craftvia/craftvia-core-s-RP235xA/docs/images/2D_PCB1_back_2026-11-04.png

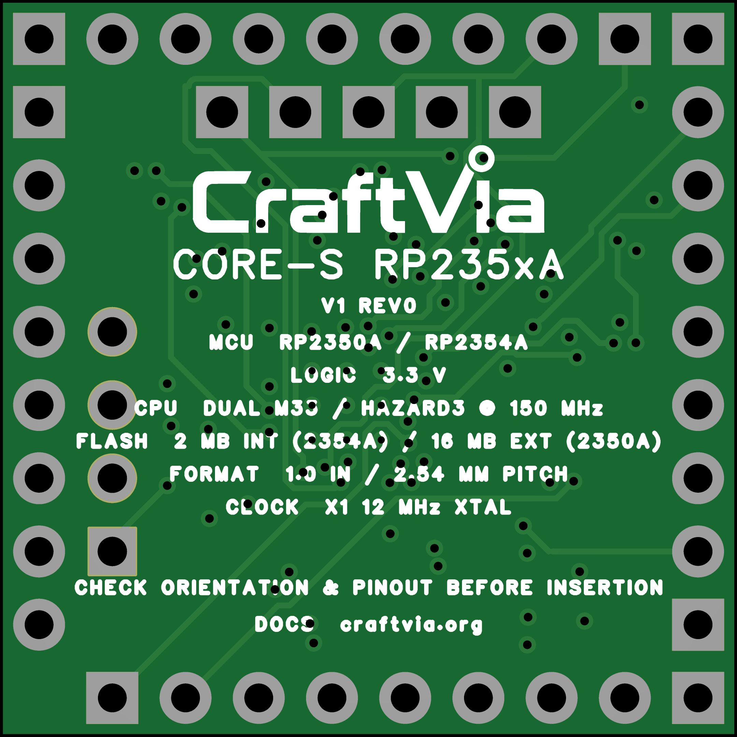
docs/images/2D_PCB1_back_2026-11-04.png
