craftvia/craftvia-core-s-RP235xA/assembly/BOM_Board1_PCB1_2026-11-04.csv

No. | Quantity | Comment | Designator | Footprint | Value | Manufacturer Part | Manufacturer | Supplier Part | Supplier | LCSC Part Name | Description | Mounting Type | DNP
1 | 10 | 100n | C1,C2,C3,C4,C5,C6,C7,C8,C9,C10 | C0402 | 100n | GRM155R71E104KE14D | muRata(村田) | C77014 | LCSC | 100nF ±10% 25V | Capacitance:100nF Tolerance:±10% Tolerance:±10% Voltage Rating:25V Temperature Coefficient:X7R
2 | 3 | 4.7u | C11,C12,C13 | C0402 | 4.7u | GRM155R60J475ME47D | muRata(村田) | C82453 | LCSC | 4.7uF ±20% 6.3V | Capacitance:4.7uF Tolerance:±20% Tolerance:±20% Voltage Rating:6.3V Temperature Coefficient:X5R
3 | 1 | 10u | C14 | C0805 | 10u | GRM21BR61C106KE15L | muRata(村田) | C77075 | LCSC | 10uF ±10% 16V | Capacitance: Tolerance:±10% Tolerance:±10% Voltage Rated: Temperature Coefficient:
4 | 2 | 15p | C15,C16 | C0402 | 15p | GRM1555C1H150JA01D | muRata(村田) | C76950 | LCSC | 15pF ±5% 50V | Capacitance:15pF Tolerance:±5% Tolerance:±5% Voltage Rating:50V Temperature Coefficient:C0G
5 | 1 | 100n (RP2350A ONLY / DNP RP2354A) | C17 | C0402 | 100nF | GRM155R71E104KE14D | muRata(村田) | C77014 | LCSC | 100nF ±10% 25V | Capacitance:100nF Tolerance:±10% Tolerance:±10% Voltage Rating:25V Temperature Coefficient:X7R |  | RP2354A
6 | 1 | N 1-8 | J1 | HDR-TH_8P-P2.54-V-M |  | 直排针2.54mm 1*8P |  | Header2.54mm 1*8P.1 | LCSC
7 | 1 | E 1-8 | J2 | HDR-TH_8P-P2.54-V-M |  | 直排针2.54mm 1*8P |  | Header2.54mm 1*8P.1 | LCSC
8 | 1 | S 1-8 | J3 | HDR-TH_8P-P2.54-V-M |  | 直排针2.54mm 1*8P |  | Header2.54mm 1*8P.1 | LCSC
9 | 1 | W 1-8 | J4 | HDR-TH_8P-P2.54-V-M |  | 直排针2.54mm 1*8P |  | Header2.54mm 1*8P.1 | LCSC
10 | 1 | K-NW | J5 | CraftVia-Core-S-KEY-TH_1P-P2.54-D1.00-P1.80 |  | 2.54-1*1P针 | BOOMELE(博穆精密) | Header-Male-2.54_1x1.1 | LCSC
11 | 1 | K-NE | J6 | CraftVia-Core-S-KEY-TH_1P-P2.54-D1.00-P1.80 |  | 2.54-1*1P针 | BOOMELE(博穆精密) | Header-Male-2.54_1x1.1 | LCSC
12 | 1 | K-SW | J7 | CraftVia-Core-S-KEY-TH_1P-P2.54-D1.00-P1.80 |  | 2.54-1*1P针 | BOOMELE(博穆精密) | Header-Male-2.54_1x1.1 | LCSC
13 | 1 | AUX GPIO20-23 / 2.54mm PTH | J8 | HDR-TH_HDR-M_2.54_1X4P |  | HDR-M_2.54_1x4P |  | C9900236824 | LCSC | HDR-M_2.54_1x4P
14 | 1 | AOTA-B201610S3R3-101-T | L1 | IND-SMD_L2.0-W1.6_AOTA-B201610S3R3-101-T | 3.3uH | AOTA-B201610S3R3-101-T | ABRACON | C42411119 | LCSC | 3.3uH 2.4A
15 | 1 | 0R / FB INPUT FILTER | R1 | R0603 | 0R | 0603WAF0000T5E | UNI-ROYAL(厚声) | 0603WAF0000T5E.1 | LCSC |  | Default 0 ohm. Replace with same-footprint ferrite bead only after noise/ADC/EMI evaluation. |  | No
16 | 1 | 33 | R2 | R0402 | 33 | RC0402FR-0733RL | YAGEO(国巨) | C138002 | LCSC | 厚膜电阻 33Ω ±1% 62.5mW | Type:Thick Film Resistor Resistance:33Ω Tolerance:±1% Tolerance:±1% Power(Watts):62.5mW Voltage-Supply(Max):50V Temperature Coefficient:±100ppm/℃ Temperature Coefficient:±100ppm/℃ Operating Temperature:-55℃~+155℃ Operating Temperature:-55℃~+155℃
17 | 2 | 1k | R3,R4 | R0402 | 1k | RC0402FR-071KL | YAGEO(国巨) | C106235 | LCSC | 厚膜电阻 1kΩ ±1% 62.5mW | Type:Thick Film Resistor Resistance:1kΩ Tolerance:±1% Tolerance:±1% Power(Watts):62.5mW Voltage-Supply(Max):50V Temperature Coefficient:±100ppm/℃ Temperature Coefficient:±100ppm/℃ Operating Temperature:-55℃~+155℃ Operating Temperature:-55℃~+155℃
18 | 2 | 27 | R5,R6 | R0402 | 27 | RC0402FR-0727RL | YAGEO(国巨) | C138021 | LCSC | 厚膜电阻 27Ω ±1% 62.5mW | Type:Thick Film Resistor Resistance:27Ω Tolerance:±1% Tolerance:±1% Power(Watts):62.5mW Voltage-Supply(Max):50V Temperature Coefficient:±100ppm/℃ Temperature Coefficient:±100ppm/℃ Operating Temperature:-55℃~+155℃ Operating Temperature:-55℃~+155℃
19 | 1 | 0R (RP2350A ONLY / DNP RP2354A) | R7 | R0402 | 0Ω | RC0402JR-070RL | YAGEO(国巨) | C60485 | LCSC | 厚膜电阻 0Ω ±5% 62.5mW | Type:Thick Film Resistor Resistance:0Ω Tolerance:±5% Tolerance:±5% Power(Watts):62.5mW Voltage-Supply(Max):50V Temperature Coefficient:- Temperature Coefficient:- Operating Temperature:-55℃~+155℃ Operating Temperature:-55℃~+155℃ |  | RP2354A
20 | 1 | 10k (RP2350A ONLY / DNP RP2354A) | R8 | R0402 | 10kΩ | RC0402FR-0710KL | YAGEO(国巨) | C60490 | LCSC | 厚膜电阻 10kΩ ±1% 62.5mW | Type:Thick Film Resistor Resistance:10kΩ Tolerance:±1% Tolerance:±1% Power(Watts):62.5mW Voltage-Supply(Max):50V Temperature Coefficient:±100ppm/℃ Temperature Coefficient:±100ppm/℃ Operating Temperature:-55℃~+155℃ Operating Temperature:-55℃~+155℃ |  | RP2354A
21 | 1 | RP2354A | U1 | QFN-60_L7.0-W7.0-P0.40-TL-EP3.4 | RP2354A | RP2354A | Raspberry Pi(树莓派) | C41378174 | LCSC | SC1511(13)-A4 | CPU Core:ARM Cortex-M33 CPU Maximum Speed:150MHz Core Size:32 Bit Oscillator Type:Built-in+External Features:Independent watchdog (IWDG)；Undervoltage detection (BOR/LVD/LVR/LVI)；Calendar function；Power-on reset (POR)；True random number generator (TRNG)；Wa
22 | 1 | W25Q128JVSIQ (RP2350A ONLY / DNP FOR RP2354A) | U2 | SOIC-8_L5.3-W5.3-P1.27-LS8.0-BL |  | W25Q128JVSIQ | Winbond(华邦) | C97521 | LCSC | 编带 支持双路/四路SPI接口的3V、128Mbit 串行闪存 | Interface:SPI Memory Size:128Mbit Clock Frequency:133MHz Voltage - Supply:2.7V~3.6V Voltage - Supply:2.7V~3.6V Standby Supply Current:1uA Program / Erase Cycles:100,000 cycles Write Cycle Time (tWC):- Page Programming Time (Tpp):3ms Block Erase Time(tBE): |  | RP2354A
23 | 1 | 12MHz | X1 | CRYSTAL-SMD_4P-L3.2-W2.5-BL | 12MHz | ABM8-272-T3 | ABRACON | C20625731 | LCSC | 12MHz ±30ppm 10pF | Type:SMD crystal oscillator Frequency:12MHz Normal temperature Frequency Tolerance:±30ppm Normal temperature Frequency Tolerance:±30ppm Load Capacitance:10pF Frequency Stability:±30ppm Frequency Stability:±30ppm Equivalent Series Resistance(ESR):50Ω Opera
