craftvia/craftvia-core-s-RP235xA/docs/SCH_Schematic1_2026-11-04.pdf

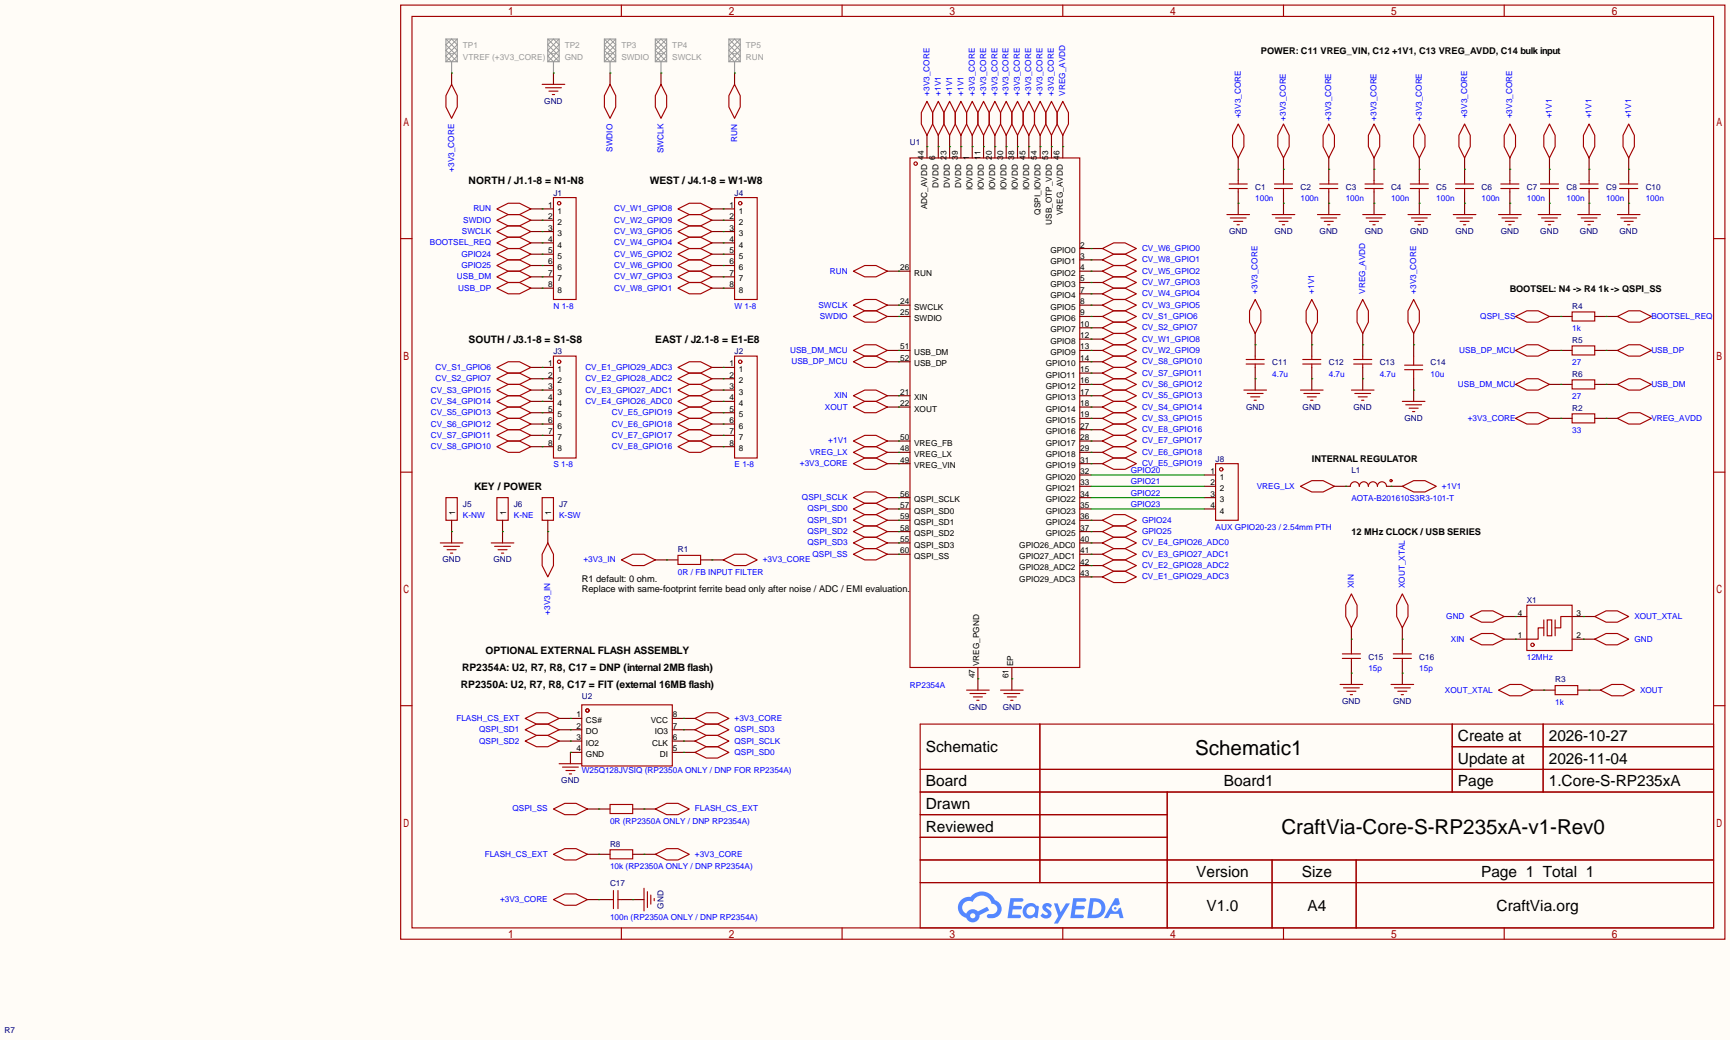
[picture p4: page 1]

12 MHz CLOCK / USB SERIES

R1 default: 0 ohm.
Replace with same-footprint ferrite bead only after noise / ADC / EMI evaluation.

OPTIONAL EXTERNAL FLASH ASSEMBLY
RP2354A: U2, R7, R8, C17 = DNP (internal 2MB flash)
RP2350A: U2, R7, R8, C17 = FIT (external 16MB flash)

Schematic | Schematic1 | Create at | 2026-10-27

Update at | 2026-11-04

Board | Board1 | Page | 1.Core-S-RP235xA
Drawn | | CraftVia-Core-S-RP235xA-v1-Rev0
Reviewed

Version | Size | Page 1 Total 1
V1.0 | A4 | CraftVia.org
