craftvia/craftvia-core-s-RP235xA/(list of files, drawings)

Other design files:
source/ProPrj_CraftVia-Core-S-RP235xA-v1-Rev0_2026-11-04.epro
