craftvia/craftvia-core-s-RP235xA/RELEASE_NOTES.md

# CraftVia Core-S RP235xA v1 Rev0 Hardware Release

## Release status

- Revision: Rev0
- Freeze date: 2026-11-04 00:03 JST
- Status: FROZEN for initial prototype PCB fabrication
- Hardware status: PCB ordered; awaiting delivery, unassembled and unverified
- Intended use: Rev0 engineering prototype; not a general-production release
- Default assembly variant: `RP2354A + internal 2 MB Flash`
- Alternate assembly variant: `RP2350A + external W25Q128JVSIQ 16 MB Flash`
- Assembly plan: bare-PCB fabrication followed by manual/hot-plate assembly; no turnkey PCBA is planned for the first article
- CAD: EasyEDA Pro `v3.2.209`; frozen project database schema `25.10.31.1`
- Checked by: Kohei (design owner) and Codex (release-file consistency review)
- Authoritative editable source: `source/CraftVia-Core-S-RP235xA-v1-Rev0.eprj2`
- Authoritative source SHA-256: `5936228bfc046cde501f23ae7750e1628e2d58f97b65985f5ef830f0cfee4319`
- Authoritative PCB fabrication upload: `fabrication/Gerber_PCB1_2026-11-04.zip`

The EasyEDA Pro application version is recorded from the final Gerber export header. The portable project, schematic and PCB titles identify this release as RP235xA. The authoritative `.eprj2` retains the historical `projects.name` value `CraftVia-Core-S-v1-Mechanical-Template` as EasyEDA workflow-link metadata; this accepted metadata does not identify the released circuit or fabrication data.

## Release decision

The package is acceptable for an initial Rev0 bare-PCB fabrication order and manual first-article assembly, subject to the ordering, assembly-variant and bring-up conditions below.

- PCB DRC: PASS, 0 detected items, as confirmed in EasyEDA after final routing and copper rebuild before export
- Schematic DRC: Fatal 0, Error 0, Warning 2
- The two schematic warnings are EasyEDA Supplier Part/component-attribute normalization warnings and do not report an electrical-connectivity error.
- Gerber ZIP integrity, drill readability and required layer presence: PASS
- Frozen `.eprj2` SQLite integrity and portable `.epro` ZIP integrity: PASS
- BOM/CPL reconciliation: PASS; all 37 BOM designators occur once in the CPL, with five additional non-BOM test-point rows (`TP1`-`TP5`)
- Assembly/BOM/PCB reference PDF: 9 pages; Top placement, empty Bottom-placement page, BOM pages and PCB reference plots
- Schematic PDF: 1 page
- Board: 25.40 mm x 25.40 mm, 4 copper layers, nominal finished thickness 1.60 mm

The exported CPL is intentionally unfiltered. It contains both assembly-variant choices and the five physical test points. It is suitable for coordinate, side and rotation audit, but must be filtered according to the selected MCU variant before any turnkey assembly order.

## Release contents

| Path | Purpose |
| --- | --- |
| `source/CraftVia-Core-S-RP235xA-v1-Rev0.eprj2` | Authoritative editable EasyEDA project |
| `source/ProPrj_CraftVia-Core-S-RP235xA-v1-Rev0_2026-11-04.epro` | Portable EasyEDA project archive |
| `fabrication/Gerber_PCB1_2026-11-04.zip` | Canonical PCB fabrication package |
| `assembly/BOM_Board1_PCB1_2026-11-04.csv` | Full BOM with MCU-variant DNP metadata |
| `assembly/PickAndPlace_PCB1_2026_11_04.csv` | Unfiltered EasyEDA CPL containing 37 BOM parts and five test points |
| `assembly/PCB_PCB1_2026-11-04.pdf` | EasyEDA assembly, BOM and PCB reference export |
| `docs/SCH_Schematic1_2026-11-04.pdf` | Human-readable schematic reference |
| `SHA256SUMS.txt` | Per-file SHA-256 integrity manifest |

The three files under `img/` are convenience renderings only. They are intentionally retained for visual reference but are not release masters and are excluded from `SHA256SUMS.txt`. DRC log files are intentionally not frozen; the accepted DRC results and warning disposition are recorded in this README.

## PCB fabrication package

Upload `fabrication/Gerber_PCB1_2026-11-04.zip` directly to the PCB manufacturer. Do not edit or recompress its contents.

The ZIP contains:

- Top, Inner 1, Inner 2 and Bottom copper
- Top and Bottom solder mask
- Top and Bottom silkscreen
- Top paste mask
- Top assembly and document layers
- Board outline
- PTH component-hole drill and PTH via drill
- Flying-probe test description generated by EasyEDA

No NPTH drill file is present. The Core-S edge/header holes, J8 holes and test/thermal vias are intentionally plated. No Bottom paste file is present because the standard SMT population is on the Top side.

Order and stack-up conditions:

- Manufacturer baseline: JLCPCB
- Stack-up: `JLC04161H-7628`
- Finished thickness: nominal 1.60 mm, subject to manufacturer tolerance
- Copper: L1/L4 1 oz; L2/L3 0.5 oz
- L1-L2 and L3-L4 dielectric: `7628 RC49% 8.6 mil`
- L2-L3 core: `1.1 mm H/HOZ Copper`
- USB pair: 10 mil Top-layer differential routing referenced primarily to the continuous L2 GND plane; the unavoidable crossover uses an internal-layer segment and nearby return vias
- USB differential impedance target: 90 ohm, manufacturing tolerance +/-10%
- Surface finish and solder-mask color are not encoded in Gerber. Select them explicitly when ordering and record them when the release status is updated to `ORDERED`.

Before submitting the order, load the exact ZIP into the manufacturer preview and confirm the 25.40 mm square outline, four copper layers, stack-up selection, impedance requirement, plated Core-S/J8/test-point holes, U1 exposed-pad via array, solder-mask openings, silkscreen and drill alignment. The 90-ohm target must be checked against the manufacturer's calculator for the selected production stack-up; the Gerber set is not an impedance-coupon sign-off.

## Assembly population and MCU variants

The BOM contains 23 rows and 37 component designators. The four external-Flash parts remain in the BOM with variant-aware DNP metadata so a fresh export preserves both supported configurations.

Default `RP2354A + internal 2 MB Flash` assembly:

- Fit U1 as `RP2354A`.
- Do not fit `U2`, `R7`, `R8` or `C17` (`DNP=RP2354A`).
- The RP2354A package-internal 2 MB Flash is the primary boot storage.

Alternate `RP2350A + external 16 MB Flash` assembly:

- Substitute U1 with `RP2350A` using the same QFN-60 footprint.
- Fit `U2=W25Q128JVSIQ`, `R7=0 ohm`, `R8=10 kohm` and `C17=100 nF`.
- U2 is the primary boot storage.

Do not mix the RP2354A MCU with the RP2350A external-Flash population in this Rev0 release. RP2354A plus a secondary external Flash requires a separately reviewed CS connection and boot configuration.

Additional population notes:

- `R1` is 0 ohm by default. Replace it with a same-footprint ferrite bead only after power-noise, ADC and EMI evaluation, and only after checking current rating, DC resistance and bias behavior.
- J8 is a product-specific auxiliary GPIO header for GPIO20-GPIO23 and is not part of the Core-S common interface. It appears as fitted in the exported BOM/CPL; the physical pin header may be omitted for a manual build, provided that the assembly record notes the deviation.
- `TP1`-`TP5` are physical test pads/holes, not parts to be purchased or placed. `TP1` is `VTREF (+3V3_CORE)`; TP2 is GND; TP3/TP4 are SWDIO/SWCLK; TP5 is RUN.
- All CPL rows are on the Top side and use valid 0/90/180/270-degree rotations.

For a turnkey assembly order, create and archive a variant-specific BOM and CPL. For the RP2354A variant, remove `U2`, `R7`, `R8`, `C17` and `TP1`-`TP5` from placement. For the RP2350A variant, remove `TP1`-`TP5`, change U1 to RP2350A and retain all four external-Flash parts.

## Electrical and implementation configuration

- Core-S input is 3.3 V through `R1` to `+3V3_CORE`; no onboard input regulator or input-protection stage is provided.
- U1's internal regulator generates `+1V1`; L1 and the associated bulk/decoupling network follow the RP235xA implementation.
- The 12 MHz crystal network is fitted.
- Native USB is exposed as N7=`USB_DM` and N8=`USB_DP`, with 27-ohm series resistors close to U1.
- BOOTSEL is requested through N4 and the 1-kohm series connection to `QSPI_SS`; use the documented low-during-RUN-reset sequence and return N4 to high impedance afterward.
- SWD debug uses N1=RUN, N2=SWDIO and N3=SWCLK.
- J8 exposes GPIO20-GPIO23 on a product-specific 1 x 4, 2.54 mm PTH footprint.
- U1's exposed GND pad uses a 3 x 3 plated thermal-via array. These vias are for thermal/electrical connection, not hand-solder access holes.

## DRC and documentation evidence

Schematic DRC was run before export and reported Fatal 0, Error 0 and Warning 2. The warnings are accepted because they concern supplier/component-attribute normalization rather than connectivity. PCB DRC was run after final routing and copper rebuild and reported zero detected items. Both results were confirmed in EasyEDA before the release exports were collected. DRC logs are not part of this frozen package.

The schematic PDF is a human-readable reference. The 9-page assembly PDF includes an intentionally empty Bottom-placement page because there are no standard Bottom-side components; the remaining pages provide BOM and PCB reference plots. The Gerber ZIP is the sole PCB fabrication master.

## First-article checks

1. Verify the manufacturer preview against the specified four-layer stack-up, 25.40 mm outline and 90-ohm USB differential requirement.
2. Inspect Core-S orientation/keying, all header pin-1 positions, U1 pin 1, U2 pin 1 when fitted and X1 orientation before power is applied.
3. Confirm the selected MCU/Flash population exactly matches one of the two supported variants.
4. Inspect the U1 exposed-pad 3 x 3 via array for solder wicking/void risk and use a suitably segmented stencil aperture for hot-plate reflow.
5. Power from a current-limited 3.3 V source; check for a short on `+3V3_CORE`, then verify the internal-regulator `+1V1` rail and current consumption.
6. Verify SWD attach, halt, flash erase/write/verify, RUN reset and recovery independently for RP2354A and RP2350A assemblies.
7. Verify N4 Low plus RUN-reset USB BOOTSEL operation, then application USB enumeration and reconnect behavior.
8. Validate USB through the complete Core-S and Station-S path; Station-S routing/switching must also satisfy the signal-integrity requirement.
9. Exercise all 26 Core-S GPIO signals, ADC0-ADC3, J8 GPIO20-GPIO23 and TP1-TP5 with a continuity fixture or Station-S.
10. Measure 150 MHz operation, regulator ripple, current, temperature, ADC behavior and HSTX behavior before claiming production-level performance.
11. Keep secure-boot, debug-disable and irreversible OTP settings unprogrammed during Rev0 bring-up.

## Known limitations

- This is an engineering prototype release. USB signal integrity through the complete Core-S/Station-S path, both MCU/Flash variants, hot-plate QFN yield, ADC accuracy, HSTX, power consumption and thermal behavior remain first-article validation items.
- The exported BOM names U1 as RP2354A. RP2350A assembly therefore requires an explicit U1 substitution in the assembly record and any variant-specific BOM.
- The exported CPL is not turnkey-ready because it includes DNP candidates and TP1-TP5. Filter and re-audit it before external assembly.
- J8 is included in the BOM/CPL but may be omitted in a manual build; it is not a Core-S compatibility requirement.
- Surface finish and solder-mask color remain order-time selections and must be recorded when an order is placed.
- Regeneration should use EasyEDA Pro `v3.2.209` where practical; a different build must be recorded if a later repack is required.
- The historical `.eprj2` workflow-link name is intentionally accepted for Rev0. Circuit, schematic, PCB and portable-project titles identify RP235xA.

## Change control and integrity

Verify each listed release file with `SHA256SUMS.txt` before ordering. The manifest records one SHA-256 digest per file and does not represent a directory-level digest. `SHA256SUMS.txt` does not hash itself. The three convenience images under `img/` and all DRC logs are outside the integrity manifest.

After this release is used for an order, do not overwrite any Rev0 file. Electrical, footprint, routing, silkscreen or population changes require a new revision. A documentation-only repack must preserve the `.eprj2` hash and use a separately named release directory.
