craftvia/craftvia-core-s-RP235xA/(commit log)

2026-11-10 Prepare Core-S RP235xA v1 Rev0 publication
    [BOM_Board1_PCB1_2026-11-04.csv, PickAndPlace_PCB1_2026_11_04.csv, ProPrj_CraftVia-Core-S-RP235xA-v1-Rev0_2026-11-04.epro]
2026-11-10 Record Rev0 boards as ordered
